icl-rocketry/Ricardo-CameraController/README.md

# Ricardo-CameraController
The CM5 (Compute Module 5) carrier board for cameras on rocket
