icl-rocketry/Ricardo-CameraController/Camera-controller/Camera-controller.kicad_pcb

## KiCad design Camera-controller/Camera-controller.kicad_pcb (2026-06-25)

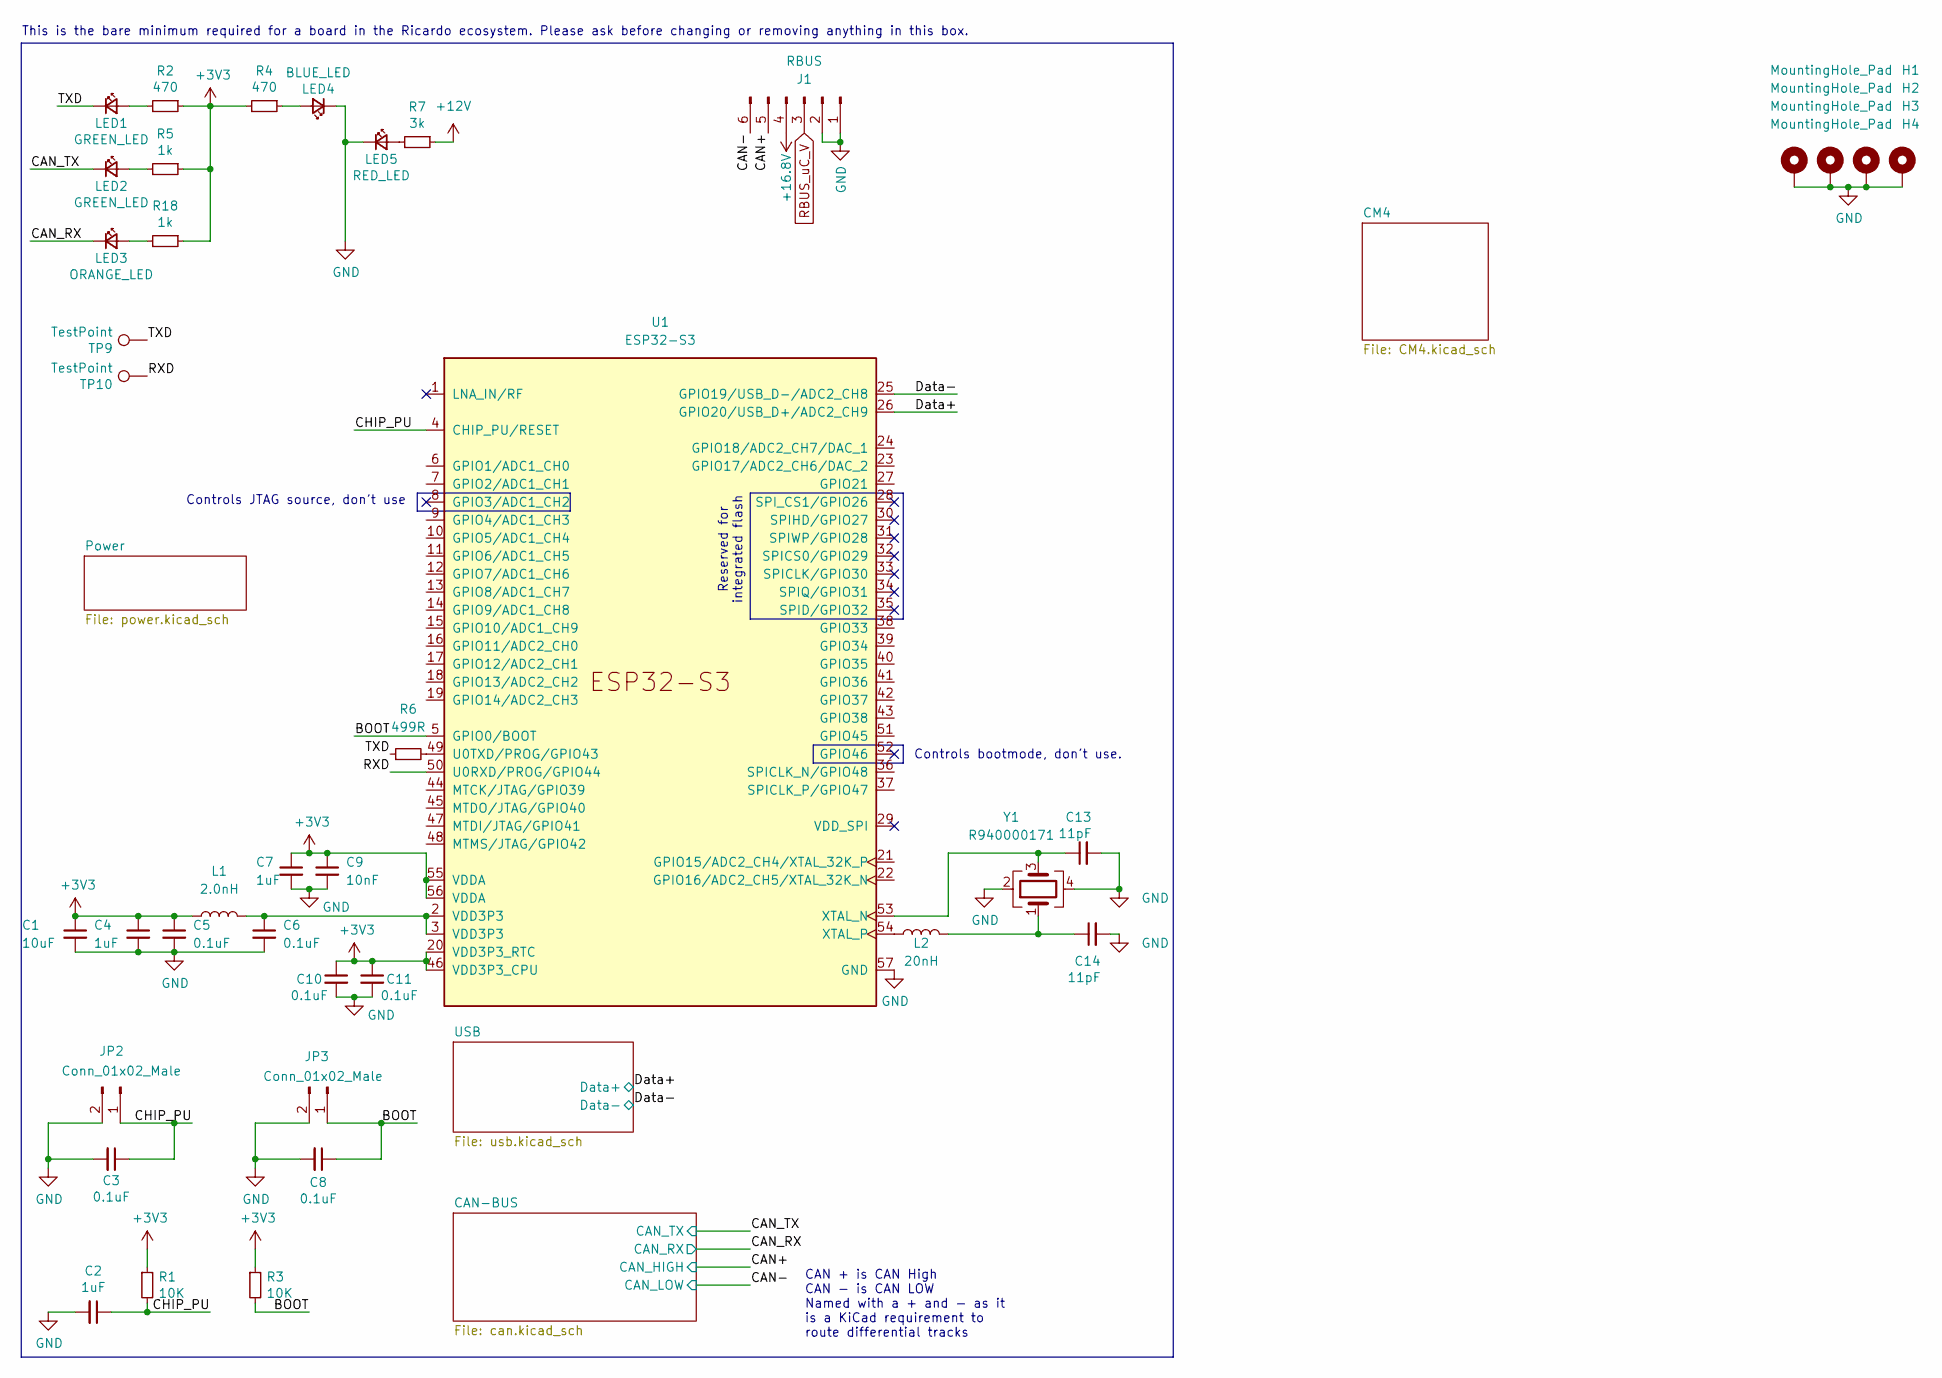
[picture p1: schematic Camera-controller.kicad_sch]

Parts:
C1: 10uF; C_0402_1005Metric
C2, C4, C7: 1uF; C_0402_1005Metric
C3, C5, C6, C8, C10, C11: 0.1uF; C_0402_1005Metric
C9: 10nF; C_0402_1005Metric
C13, C14: 11pF; C_0402_1005Metric
H1, H2, H3, H4: MountingHole_Pad; MountingHole_3.2mm_M3_DIN965_Pad
J1: RBUS; Molex_Mini-Fit_Jr_5569-06A2_2x03_P4.20mm_Horizontal
JP2, JP3: Conn_01x02_Male; PinHeader_1x02_P2.54mm_Vertical
L1: 2.0nH; L_0402_1005Metric
L2: 20nH; L_0402_1005Metric
LED1, LED2: GREEN_LED; LED_0402_1005Metric
LED3: ORANGE_LED; LED_0402_1005Metric
LED4: BLUE_LED; LED_0402_1005Metric
LED5: RED_LED; LED_0402_1005Metric
R1, R3: 10K; R_0402_1005Metric
R2, R4: 470; R_0402_1005Metric
R5, R18: 1k; R_0402_1005Metric
R6: 499R; R_0402_1005Metric
R7: 3k; R_0402_1005Metric
TP9, TP10: TestPoint; TestPoint_Pad_D1.0mm
U1: ESP32-S3; QFN40P700X700X90-57N
Y1: R940000171; Crystal_SMD_2016-4Pin_2.0x1.6mm

Connections:
+3V3: C1.1, C4.1, C5.1, C7.1, C9.1, C10.1, C11.1, L1.1, R1.1, R2.1, R3.1, R4.2, R5.1, R18.1, U1.20 (VDD3P3_RTC), U1.46 (VDD3P3_CPU), U1.55 (VDDA), U1.56 (VDDA); also elsewhere on the board
+12V: R7.1
+16.8V: J1.4; also elsewhere on the board
/BOOT: C8.1, JP3.1, R3.2, U1.5 (GPIO0/BOOT)
/CAN+: J1.5; also elsewhere on the board
/CAN-: J1.6; also elsewhere on the board
/CAN_RX: LED3.1 (K); also elsewhere on the board
/CAN_TX: LED2.1 (K); also elsewhere on the board
/CHIP_PU: C2.1, C3.1, JP2.1, R1.2, U1.4 (CHIP_PU/RESET)
/Data+: U1.26 (GPIO20/USB_D+/ADC2_CH9); also elsewhere on the board
/Data-: U1.25 (GPIO19/USB_D-/ADC2_CH8); also elsewhere on the board
/RXD: TP10.1, U1.50 (U0RXD/PROG/GPIO44)
/TXD: LED1.1 (K), R6.1, TP9.1
GND: C1.2, C2.2, C3.2, C4.2, C5.2, C6.2, C7.2, C8.2, C9.2, C10.2, C11.2, C13.2, C14.2, H1.1, H2.1, H3.1, H4.1, J1.1, J1.2, JP2.2, JP3.2, LED4.1 (K), LED5.1 (K), U1.57 (GND), Y1.2, Y1.4; also elsewhere on the board
unnamed: C6.1, L1.2, U1.2 (VDD3P3), U1.3 (VDD3P3)
unnamed: C14.1, L2.2, Y1.1
unnamed: LED1.2 (A), R2.2
unnamed: LED2.2 (A), R5.2
unnamed: LED3.2 (A), R18.2
unnamed: LED4.2 (A), R4.1
unnamed: LED5.2 (A), R7.2
unnamed: R6.2, U1.49 (U0TXD/PROG/GPIO43)
unnamed: C13.1, U1.53 (XTAL_N), Y1.3
unnamed: L2.1, U1.54 (XTAL_P)
RBUS_uC_V: J1.3; also elsewhere on the board

Notes on the sheet:
Controls bootmode, don't use.
This is the bare minimum required for a board in the Ricardo ecosystem. Please ask before changing or removing anything in this box.
CAN + is CAN High CAN - is CAN LOW Named with a + and - as it is a KiCad requirement to route differential tracks
Controls JTAG source, don't use
Reserved for integrated flash

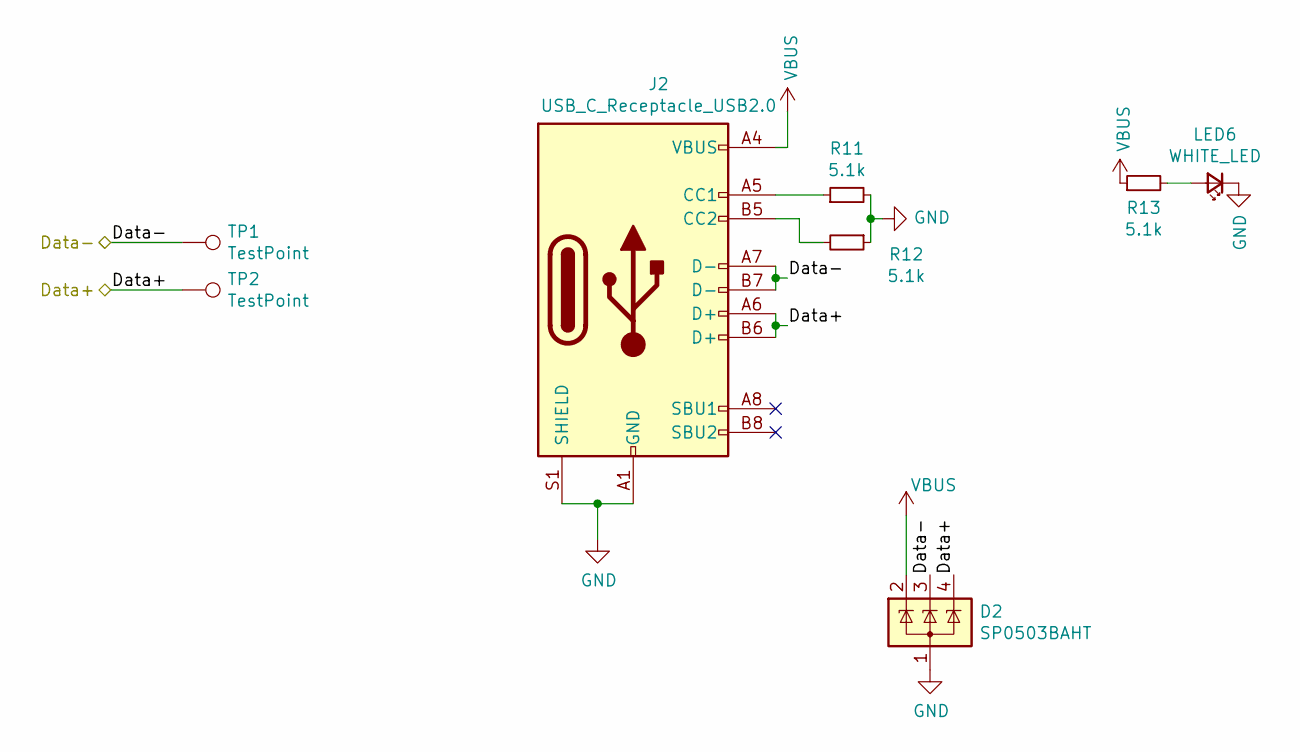
[picture p2: schematic usb.kicad_sch]

Parts:
D2: SP0503BAHT; SOT-143
J2: USB_C_Receptacle_USB2.0; USB_C_Receptacle_Palconn_UTC16-G
LED6: WHITE_LED; LED_0402_1005Metric
R11, R12, R13: 5.1k; R_0402_1005Metric
TP1, TP2: TestPoint; TestPoint_Pad_D1.0mm

Connections:
/Data+: D2.4 (K), J2.A6 (D+), J2.B6 (D+), TP2.1; also elsewhere on the board
/Data-: D2.3 (K), J2.A7 (D-), J2.B7 (D-), TP1.1; also elsewhere on the board
GND: D2.1 (A), J2.A1 (GND), J2.A12 (GND), J2.B1 (GND), J2.B12 (GND), J2.S1 (SHIELD), LED6.1 (K), R11.2, R12.1; also elsewhere on the board
unnamed: J2.A5 (CC1), R11.1
unnamed: J2.B5 (CC2), R12.2
unnamed: LED6.2 (A), R13.2
VBUS: D2.2 (K), J2.A4 (VBUS), J2.A9 (VBUS), J2.B4 (VBUS), J2.B9 (VBUS), R13.1; also elsewhere on the board

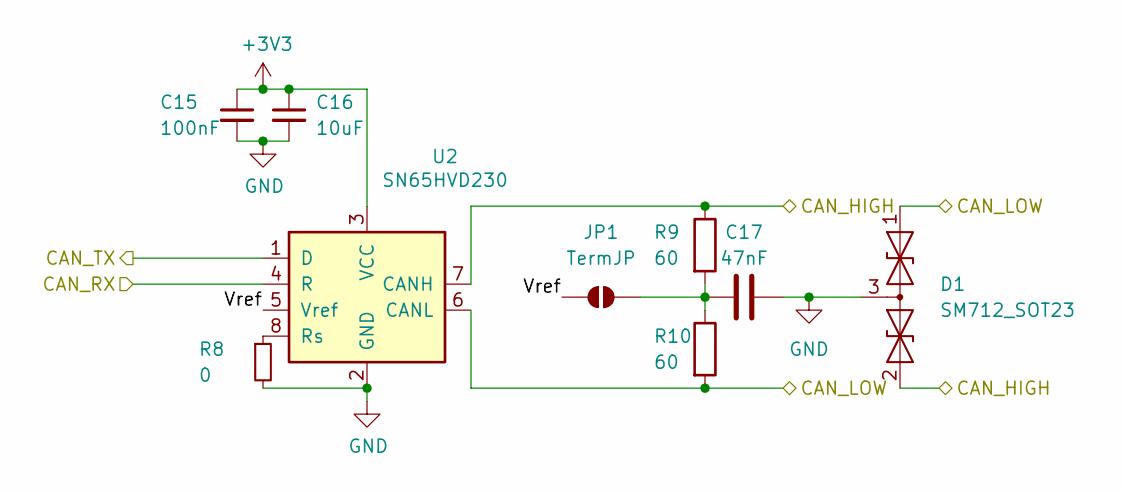
[picture p3: schematic can.kicad_sch]

Parts:
C15: 100nF; C_0402_1005Metric
C16: 10uF; C_0402_1005Metric
C17: 47nF; C_0402_1005Metric
D1: SM712_SOT23; SOT-23
JP1: TermJP; SmallerSolderJP
R8: 0; R_0603_1608Metric
R9, R10: 60; R_0603_1608Metric
U2: SN65HVD230; SOIC-8_3.9x4.9mm_P1.27mm

Connections:
+3V3: C15.1, C16.1, U2.3 (VCC); also elsewhere on the board
/CAN+: D1.2 (A2), R9.1, U2.7 (CANH); also elsewhere on the board
/CAN-: D1.1 (A1), R10.2, U2.6 (CANL); also elsewhere on the board
/CAN-BUS/Vref: JP1.1 (A), U2.5 (Vref)
/CAN_RX: U2.4 (R); also elsewhere on the board
/CAN_TX: U2.1 (D); also elsewhere on the board
GND: C15.2, C16.2, C17.2, D1.3 (common), R8.2, U2.2 (GND); also elsewhere on the board
unnamed: C17.1, JP1.2 (B), R9.2, R10.1
unnamed: R8.1, U2.8 (Rs)

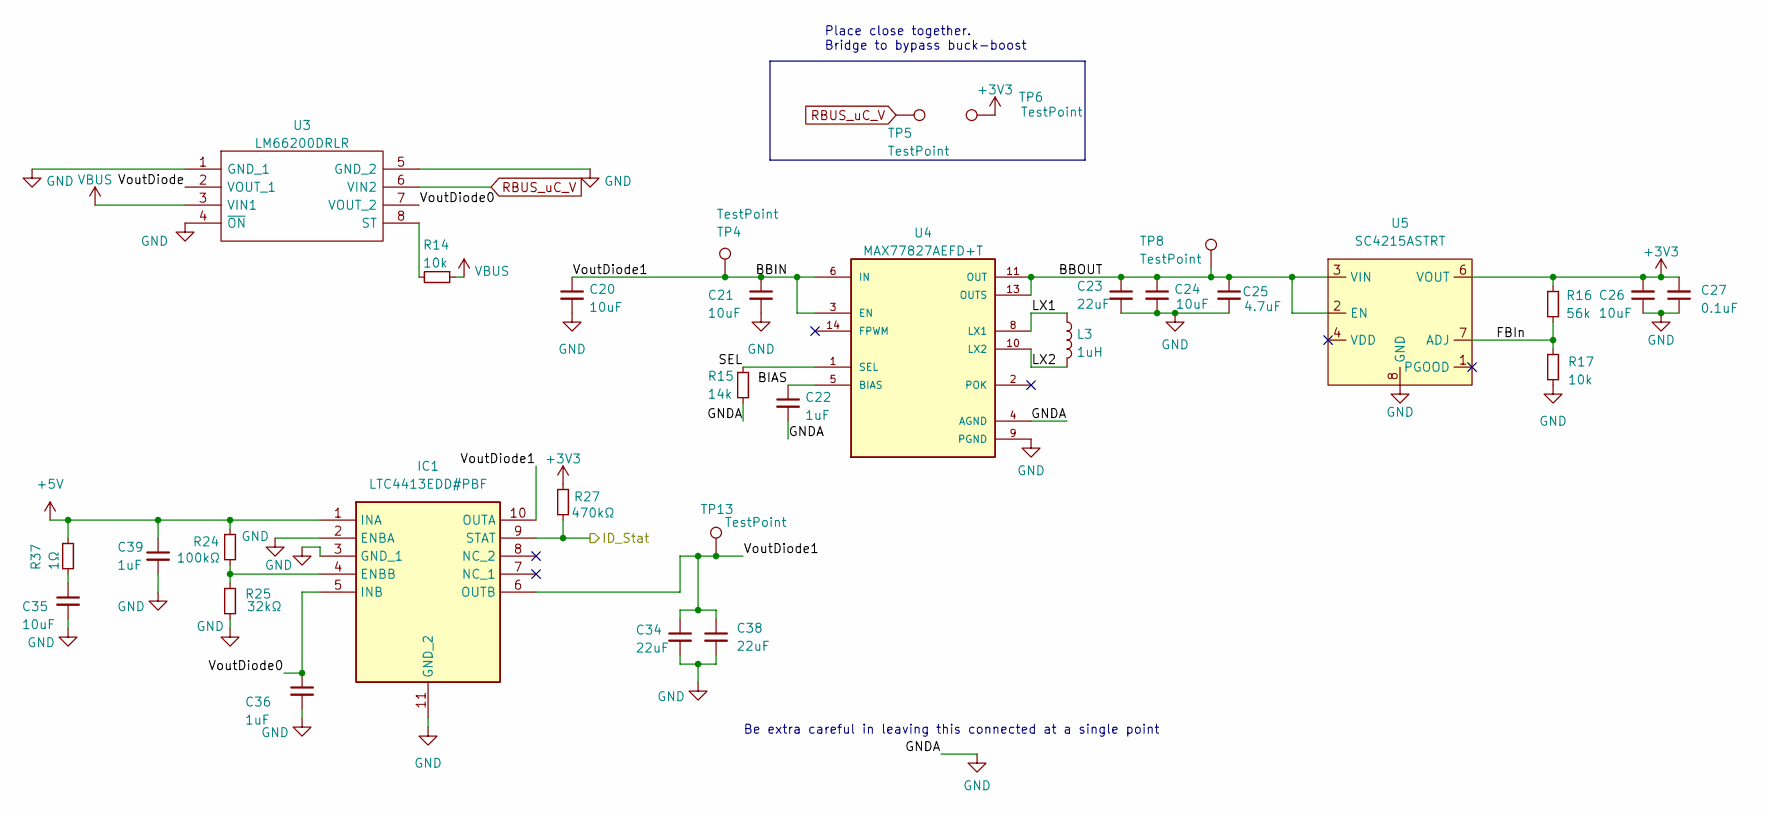
[picture p4: schematic power.kicad_sch]

Parts:
C20, C24, C26, C35: 10uF; C_0402_1005Metric
C21: 10uF; C_0603_1608Metric
C22, C36, C39: 1uF; C_0402_1005Metric
C23: 22uF; C_0603_1608Metric
C25: 4.7uF; C_0402_1005Metric
C27: 0.1uF; C_0402_1005Metric
C34, C38: 22uF; C_0402_1005Metric
IC1: LTC4413EDD#PBF; SON50P300X300X80-11N-D; Mouser Part Number 584-LTC4413EDD#PBF
L3: 1uH; L_0805_2012Metric
R14, R17: 10k; R_0402_1005Metric
R15: 14k; R_0402_1005Metric
R16: 56k; R_0402_1005Metric
R24: 100kΩ; R_0402_1005Metric
R25: 32kΩ; R_0402_1005Metric
R27: 470kΩ; R_0402_1005Metric
R37: 1Ω; R_0402_1005Metric
TP4, TP5, TP6, TP8: TestPoint; TestPoint_Pad_D1.5mm
TP13: TestPoint; TestPoint_Pad_D1.0mm
U3: LM66200DRLR; SOTFL50P160X60-8N; Manufacturer_Part_Number LM66200DRLR; Mouser Part Number 595-LM66200DRLR
U4: MAX77827AEFD+T; CONV_MAX77827AEFD+T; PARTREV B
U5: SC4215ASTRT; SOIC127P599X175-9N

Connections:
+3V3: C26.2, C27.2, R16.1, R27.1, TP6.1, U5.6 (VOUT); also elsewhere on the board
+5V: C39.1, IC1.1 (INA), R24.1, R37.1; also elsewhere on the board
/Power/BBIN: C20.1, C21.1, C34.1, C38.1, IC1.6 (OUTB), IC1.10 (OUTA), TP4.1, TP13.1, U4.3 (EN), U4.6 (IN)
/Power/BBOUT: C23.1, C24.1, C25.1, TP8.1, U4.11 (OUT), U4.13 (OUTS), U5.2 (EN), U5.3 (VIN)
/Power/BIAS: C22.1, U4.5 (BIAS)
/Power/FBIn: R16.2, R17.1, U5.7 (ADJ)
/Power/ID_Stat: IC1.9 (STAT), R27.2
/Power/LX1: L3.1, U4.8 (LX1)
/Power/LX2: L3.2, U4.10 (LX2)
/Power/SEL: R15.1, U4.1 (SEL)
/Power/VoutDiode: U3.2 (VOUT_1)
/Power/VoutDiode0: C36.1, IC1.5 (INB), U3.7 (VOUT_2)
GND: C20.2, C21.2, C22.2, C23.2, C24.2, C25.2, C26.1, C27.1, C34.2, C35.2, C36.2, C38.2, C39.2, IC1.2 (ENBA), IC1.3 (GND_1), IC1.11 (GND_2), R15.2, R17.2, R25.2, U3.1 (GND_1), U3.4 (~ON), U3.5 (GND_2), U4.4 (AGND), U4.9 (PGND), U5.8 (GND), U5.9 (GND); also elsewhere on the board
unnamed: C35.1, R37.2
unnamed: IC1.4 (ENBB), R24.2, R25.1
unnamed: R14.2, U3.8 (ST)
RBUS_uC_V: TP5.1, U3.6 (VIN2); also elsewhere on the board
VBUS: R14.1, U3.3 (VIN1); also elsewhere on the board

Notes on the sheet:
Place close together. Bridge to bypass buck-boost
Be extra careful in leaving this connected at a single point

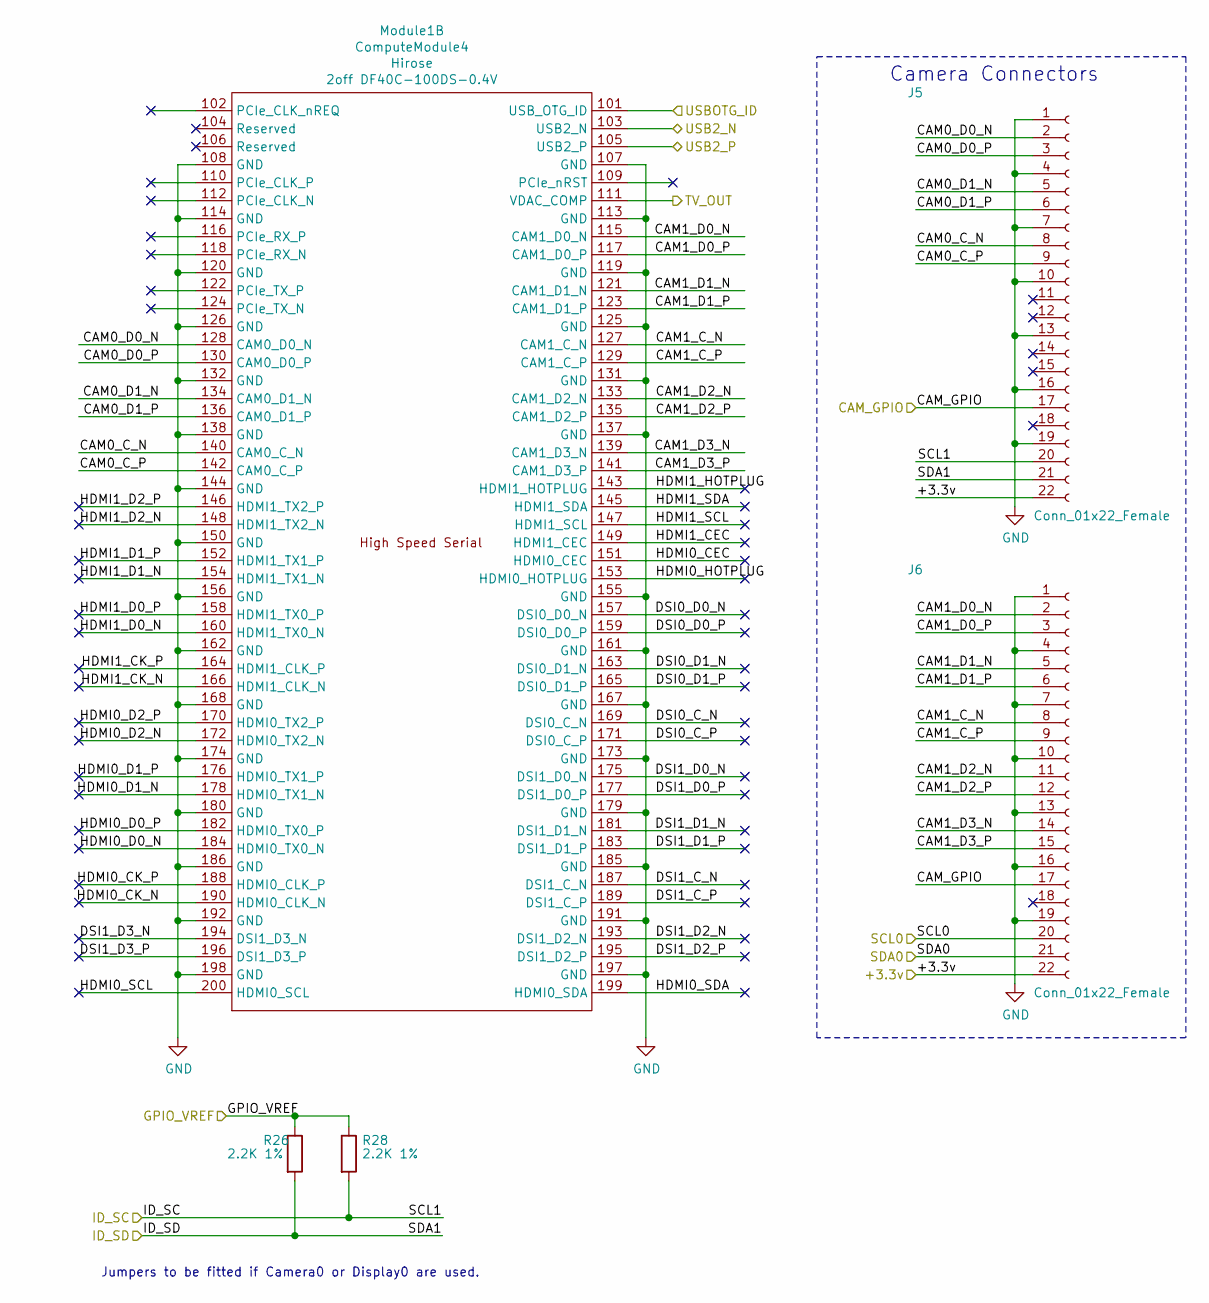
[picture p5: schematic CM4_HighSpeed.kicad_sch, Compute Module 4 IO Board - CM4 - Highspeed]

Parts:
J5, J6: Conn_01x22_Female; Hirose_FH12-22S-0.5SH_1x22-1MP_P0.50mm_Horizontal; Part Description 22 Position FFC, FPC Connector Contacts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
Module1: ComputeModule4; Raspberry-Pi-4-Compute-Module; Part Description 100 Position Connector Receptacle, Cent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
R26, R28: 2.2K 1%; R_0402_1005Metric; Part Description Resistor 2.2K M1005 1% 63mW

Connections:
/CM4/+3.3v: J5.22, J6.22; also elsewhere on the board
/CM4/CM4 _HighSpeed/CAM0_C_N: J5.8, Module1.140 (CAM0_C_N)
/CM4/CM4 _HighSpeed/CAM0_C_P: J5.9, Module1.142 (CAM0_C_P)
/CM4/CM4 _HighSpeed/CAM0_D0_N: J5.2, Module1.128 (CAM0_D0_N)
/CM4/CM4 _HighSpeed/CAM0_D0_P: J5.3, Module1.130 (CAM0_D0_P)
/CM4/CM4 _HighSpeed/CAM0_D1_N: J5.5, Module1.134 (CAM0_D1_N)
/CM4/CM4 _HighSpeed/CAM0_D1_P: J5.6, Module1.136 (CAM0_D1_P)
/CM4/CM4 _HighSpeed/CAM1_C_N: J6.8, Module1.127 (CAM1_C_N)
/CM4/CM4 _HighSpeed/CAM1_C_P: J6.9, Module1.129 (CAM1_C_P)
/CM4/CM4 _HighSpeed/CAM1_D0_N: J6.2, Module1.115 (CAM1_D0_N)
/CM4/CM4 _HighSpeed/CAM1_D0_P: J6.3, Module1.117 (CAM1_D0_P)
/CM4/CM4 _HighSpeed/CAM1_D1_N: J6.5, Module1.121 (CAM1_D1_N)
/CM4/CM4 _HighSpeed/CAM1_D1_P: J6.6, Module1.123 (CAM1_D1_P)
/CM4/CM4 _HighSpeed/CAM1_D2_N: J6.11, Module1.133 (CAM1_D2_N)
/CM4/CM4 _HighSpeed/CAM1_D2_P: J6.12, Module1.135 (CAM1_D2_P)
/CM4/CM4 _HighSpeed/CAM1_D3_N: J6.14, Module1.139 (CAM1_D3_N)
/CM4/CM4 _HighSpeed/CAM1_D3_P: J6.15, Module1.141 (CAM1_D3_P)
/CM4/CM4 _HighSpeed/CAM_GPIO: J5.17, J6.17; also elsewhere on the board
/CM4/CM4 _HighSpeed/DSI0_C_N: Module1.169 (DSI0_C_N)
/CM4/CM4 _HighSpeed/DSI0_C_P: Module1.171 (DSI0_C_P)
/CM4/CM4 _HighSpeed/DSI0_D0_N: Module1.157 (DSI0_D0_N)
/CM4/CM4 _HighSpeed/DSI0_D0_P: Module1.159 (DSI0_D0_P)
/CM4/CM4 _HighSpeed/DSI0_D1_N: Module1.163 (DSI0_D1_N)
/CM4/CM4 _HighSpeed/DSI0_D1_P: Module1.165 (DSI0_D1_P)
/CM4/CM4 _HighSpeed/DSI1_C_N: Module1.187 (DSI1_C_N)
/CM4/CM4 _HighSpeed/DSI1_C_P: Module1.189 (DSI1_C_P)
/CM4/CM4 _HighSpeed/DSI1_D0_N: Module1.175 (DSI1_D0_N)
/CM4/CM4 _HighSpeed/DSI1_D0_P: Module1.177 (DSI1_D0_P)
/CM4/CM4 _HighSpeed/DSI1_D1_N: Module1.181 (DSI1_D1_N)
/CM4/CM4 _HighSpeed/DSI1_D1_P: Module1.183 (DSI1_D1_P)
/CM4/CM4 _HighSpeed/DSI1_D2_N: Module1.193 (DSI1_D2_N)
/CM4/CM4 _HighSpeed/DSI1_D2_P: Module1.195 (DSI1_D2_P)
/CM4/CM4 _HighSpeed/DSI1_D3_N: Module1.194 (DSI1_D3_N)
/CM4/CM4 _HighSpeed/DSI1_D3_P: Module1.196 (DSI1_D3_P)
/CM4/CM4 _HighSpeed/GPIO_VREF: R26.1, R28.1; also elsewhere on the board
/CM4/CM4 _HighSpeed/HDMI0_CEC: Module1.151 (HDMI0_CEC)
/CM4/CM4 _HighSpeed/HDMI0_CK_N: Module1.190 (HDMI0_CLK_N)
/CM4/CM4 _HighSpeed/HDMI0_CK_P: Module1.188 (HDMI0_CLK_P)
/CM4/CM4 _HighSpeed/HDMI0_D0_N: Module1.184 (HDMI0_TX0_N)
/CM4/CM4 _HighSpeed/HDMI0_D0_P: Module1.182 (HDMI0_TX0_P)
/CM4/CM4 _HighSpeed/HDMI0_D1_N: Module1.178 (HDMI0_TX1_N)
/CM4/CM4 _HighSpeed/HDMI0_D1_P: Module1.176 (HDMI0_TX1_P)
/CM4/CM4 _HighSpeed/HDMI0_D2_N: Module1.172 (HDMI0_TX2_N)
/CM4/CM4 _HighSpeed/HDMI0_D2_P: Module1.170 (HDMI0_TX2_P)
/CM4/CM4 _HighSpeed/HDMI0_HOTPLUG: Module1.153 (HDMI0_HOTPLUG)
/CM4/CM4 _HighSpeed/HDMI0_SCL: Module1.200 (HDMI0_SCL)
/CM4/CM4 _HighSpeed/HDMI0_SDA: Module1.199 (HDMI0_SDA)
/CM4/CM4 _HighSpeed/HDMI1_CEC: Module1.149 (HDMI1_CEC)
/CM4/CM4 _HighSpeed/HDMI1_CK_N: Module1.166 (HDMI1_CLK_N)
/CM4/CM4 _HighSpeed/HDMI1_CK_P: Module1.164 (HDMI1_CLK_P)
/CM4/CM4 _HighSpeed/HDMI1_D0_N: Module1.160 (HDMI1_TX0_N)
/CM4/CM4 _HighSpeed/HDMI1_D0_P: Module1.158 (HDMI1_TX0_P)
/CM4/CM4 _HighSpeed/HDMI1_D1_N: Module1.154 (HDMI1_TX1_N)
/CM4/CM4 _HighSpeed/HDMI1_D1_P: Module1.152 (HDMI1_TX1_P)
/CM4/CM4 _HighSpeed/HDMI1_D2_N: Module1.148 (HDMI1_TX2_N)
/CM4/CM4 _HighSpeed/HDMI1_D2_P: Module1.146 (HDMI1_TX2_P)
/CM4/CM4 _HighSpeed/HDMI1_HOTPLUG: Module1.143 (HDMI1_HOTPLUG)
/CM4/CM4 _HighSpeed/HDMI1_SCL: Module1.147 (HDMI1_SCL)
/CM4/CM4 _HighSpeed/HDMI1_SDA: Module1.145 (HDMI1_SDA)
/CM4/CM4 _HighSpeed/ID_SC: J5.20, R28.2; also elsewhere on the board
/CM4/CM4 _HighSpeed/ID_SD: J5.21, R26.2; also elsewhere on the board
/CM4/CM4 _HighSpeed/SCL0: J6.20; also elsewhere on the board
/CM4/CM4 _HighSpeed/SDA0: J6.21; also elsewhere on the board
/CM4/CM4 _HighSpeed/USBOTG_ID: Module1.101 (USB_OTG_ID); also elsewhere on the board
/CM4/CM4_GPIO/TV_OUT: Module1.111 (VDAC_COMP); also elsewhere on the board
/CM4/CM4_USB/USB2_N: Module1.103 (USB2_N); also elsewhere on the board
/CM4/CM4_USB/USB2_P: Module1.105 (USB2_P); also elsewhere on the board
GND: J5.1, J5.4, J5.7, J5.10, J5.13, J5.16, J5.19, J6.1, J6.4, J6.7, J6.10, J6.13, J6.16, J6.19, Module1.107 (GND), Module1.108 (GND), Module1.113 (GND), Module1.114 (GND), Module1.119 (GND), Module1.120 (GND), Module1.125 (GND), Module1.126 (GND), Module1.131 (GND), Module1.132 (GND), Module1.137 (GND), Module1.138 (GND), Module1.144 (GND), Module1.150 (GND), Module1.155 (GND), Module1.156 (GND), Module1.161 (GND), Module1.162 (GND), Module1.167 (GND), Module1.168 (GND), Module1.173 (GND), Module1.174 (GND), Module1.179 (GND), Module1.180 (GND), Module1.185 (GND), Module1.186 (GND), Module1.191 (GND), Module1.192 (GND), Module1.197 (GND), Module1.198 (GND); also elsewhere on the board

Notes on the sheet:
Jumpers to be fitted if Camera0 or Display0 are used.
Camera Connectors

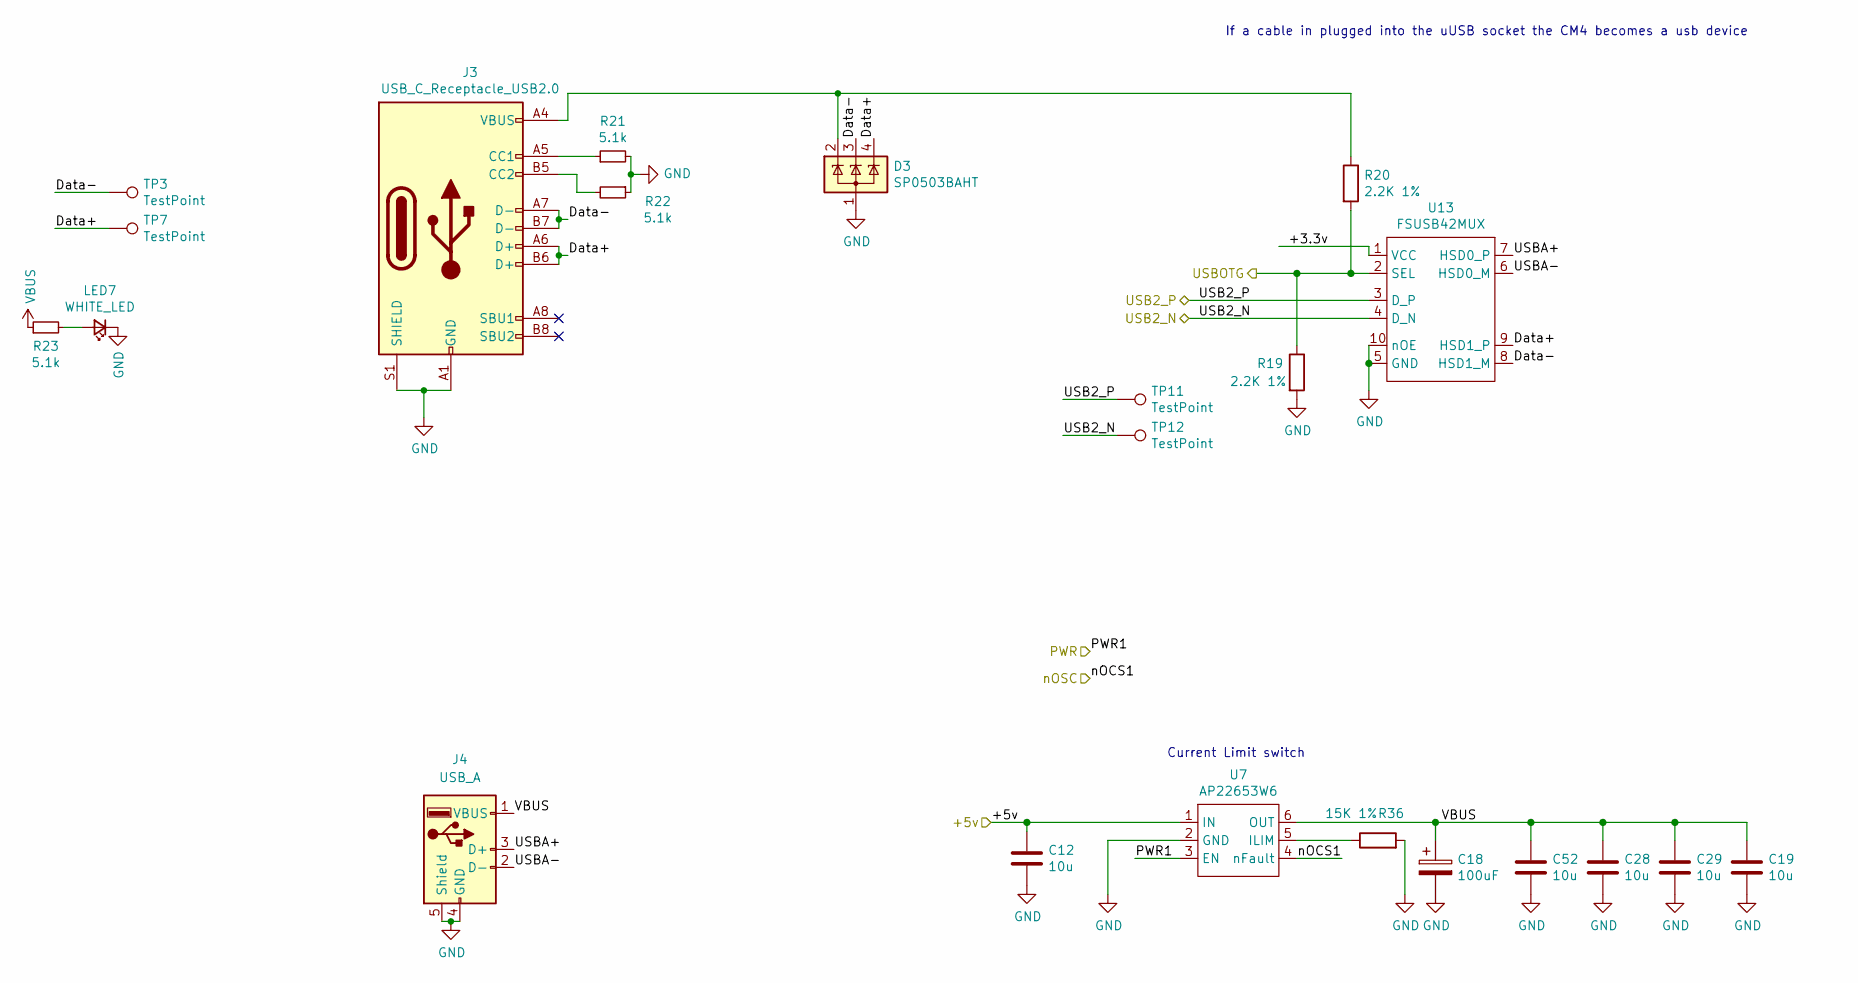
[picture p6: schematic CM4_USB.kicad_sch]

Parts:
C12, C19, C28, C29, C52: 10u; C_0805_2012Metric; Part Description 10uF 10% 10V Ceramic Capacitor X7R 0805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
C18: 100uF; CP_EIA-7343-31_Kemet-D; Part Description Capacitor, SP-Cap, 100u, 6.3V, 15mR ESR
D3: SP0503BAHT; SOT-143
J3: USB_C_Receptacle_USB2.0; USB_C_Receptacle_Palconn_UTC16-G
J4: USB_A; USB_A_Wuerth_614004134726_Horizontal
LED7: WHITE_LED; LED_0402_1005Metric
R19, R20: 2.2K 1%; R_0402_1005Metric; Part Description Resistor 2.2K M1005 1% 63mW
R21, R22, R23: 5.1k; R_0402_1005Metric
R36: 15K 1%; R_0402_1005Metric; Part Description Resistor 15K M1005 1% 63mW
TP3, TP7, TP11, TP12: TestPoint; TestPoint_Pad_D1.0mm
U7: AP22653W6; SOT-23-6; Part Description Power Switch/Driver 1:1 P-Channel 2.1A 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
U13: FSUSB42MUX; MSOP-10_3x3mm_P0.5mm; Part Description USB Switch IC 1 Channel 10-MSOP

Connections:
+5V: C12.1, U7.1 (IN); also elsewhere on the board
/CM4/CM4 _HighSpeed/USBOTG_ID: R19.1, R20.2, U13.2 (SEL); also elsewhere on the board
/CM4/CM4_USB/+3.3v: U13.1 (VCC)
/CM4/CM4_USB/Data+: D3.4 (K), J3.A6 (D+), J3.B6 (D+), TP7.1, U13.9 (HSD1_P)
/CM4/CM4_USB/Data-: D3.3 (K), J3.A7 (D-), J3.B7 (D-), TP3.1, U13.8 (HSD1_M)
/CM4/CM4_USB/PWR1: U7.3 (EN)
/CM4/CM4_USB/USB2_N: TP12.1, U13.4 (D_N); also elsewhere on the board
/CM4/CM4_USB/USB2_P: TP11.1, U13.3 (D_P); also elsewhere on the board
/CM4/CM4_USB/USBA+: J4.3 (D+), U13.7 (HSD0_P)
/CM4/CM4_USB/USBA-: J4.2 (D-), U13.6 (HSD0_M)
/CM4/CM4_USB/nOCS1: U7.4 (nFault)
GND: C12.2, C18.2, C19.2, C28.2, C29.2, C52.2, D3.1 (A), J3.A1 (GND), J3.A12 (GND), J3.B1 (GND), J3.B12 (GND), J3.S1 (SHIELD), J4.4 (GND), J4.5 (Shield), LED7.1 (K), R19.2, R21.2, R22.1, R36.2, U7.2 (GND), U13.5 (GND), U13.10 (nOE); also elsewhere on the board
unnamed: D3.2 (K), J3.A4 (VBUS), J3.A9 (VBUS), J3.B4 (VBUS), J3.B9 (VBUS), R20.1
unnamed: J3.A5 (CC1), R21.1
unnamed: J3.B5 (CC2), R22.2
unnamed: LED7.2 (A), R23.2
unnamed: R36.1, U7.5 (ILIM)
VBUS: C18.1, C19.1, C28.1, C29.1, C52.1, J4.1 (VBUS), R23.1, U7.6 (OUT); also elsewhere on the board

Notes on the sheet:
If a cable in plugged into the uUSB socket the CM4 becomes a usb device
Current Limit switch
