icl-rocketry/Ricardo-CameraController/Camera-controller/Camera-controller.kicad_pcb

## KiCad design Camera-controller/Camera-controller.kicad_pcb (continued)

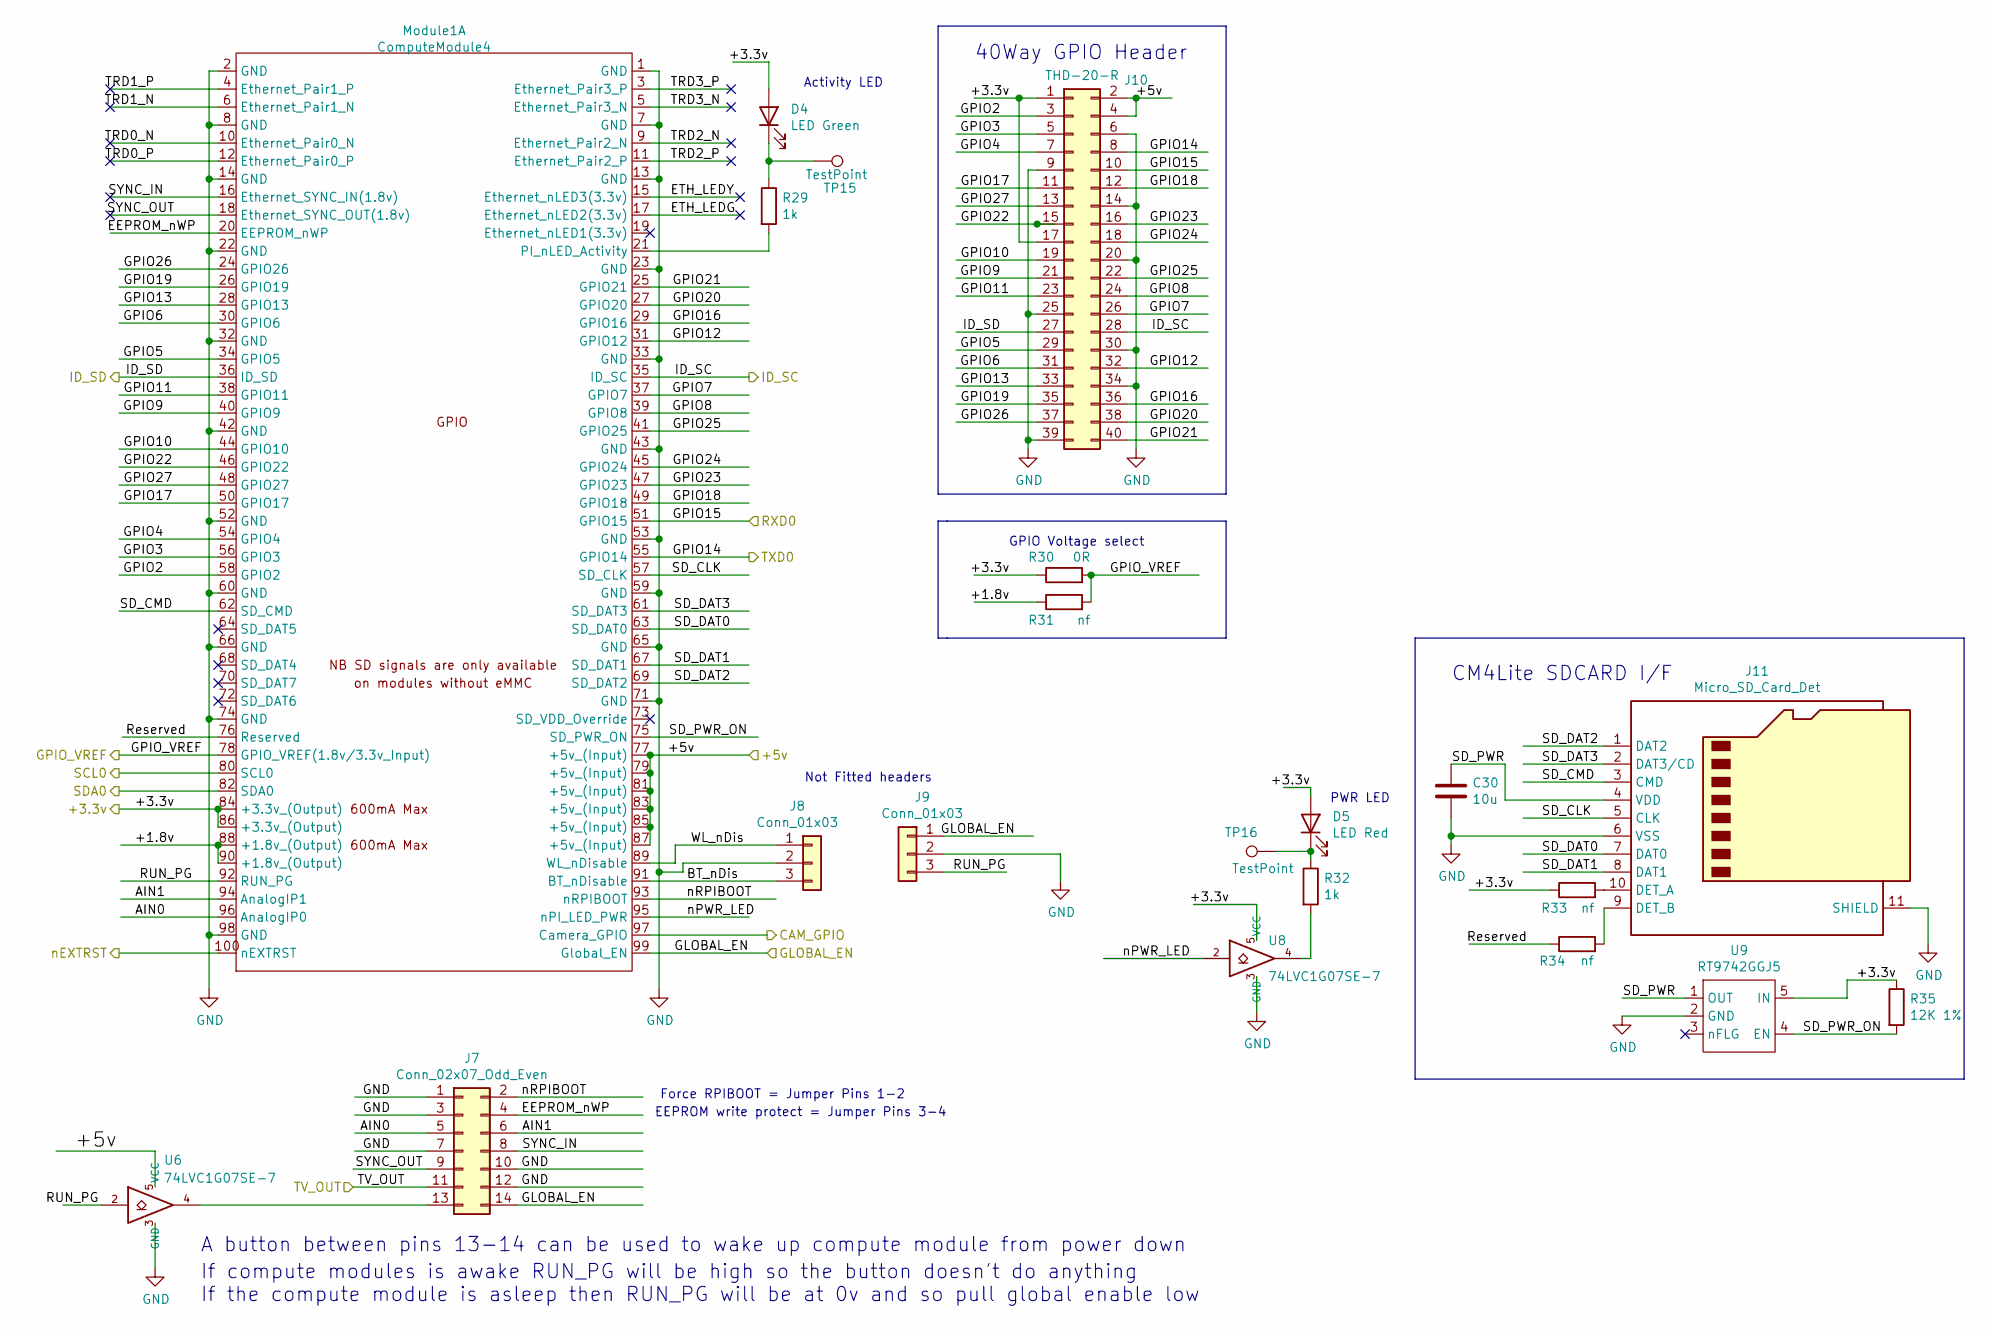
[picture p7: schematic CM4_GPIO.kicad_sch, Compute Module 4 IO Board - GPIO - Ethernet]

Parts:
C30: 10u; C_0805_2012Metric; Part Description 10uF 10% 10V Ceramic Capacitor X7R 0805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
D4: LED Green; LED_0603_1608Metric; Part Description Green 572nm LED Indication - Discrete 2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
D5: LED Red; LED_0603_1608Metric; Part Description Red 620nm LED Indication - Discrete 2.2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
J7: Conn_02x07_Odd_Even; PinHeader_2x07_P2.54mm_Vertical; Part Description PinHeader_2x07_P2.54mm_Vertical
J8, J9: Conn_01x03; PinHeader_1x03_P2.54mm_Vertical; Part Description 3pin 0.1" connector
J10: THD-20-R; PinHeader_2x20_P2.54mm_Vertical; Part Description PinHeader_2x20_P2.54mm_Vertical
J11: Micro_SD_Card_Det; SDCARD_MOLEX_503398-1892; Part Description 9 (8 + 1) Position Card Connector micro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
Module1: ComputeModule4; Raspberry-Pi-4-Compute-Module; Part Description 100 Position Connector Receptacle, Cent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
R29, R32: 1k; R_0402_1005Metric; Part Description Resistor 1K M1005 1% 63mW
R30: 0R; R_0402_1005Metric; Part Description Resistor 0R M2012 5%
R31: nf; R_0402_1005Metric
R33, R34: nf; R_0402_1005Metric; Part Description Resistor 1K M1005 1% 63mW
R35: 12K 1%; R_0402_1005Metric; Part Description Resistor 12K M1005 1% 63mW
TP15, TP16: TestPoint; TestPoint_Pad_2.0x2.0mm
U6, U8: 74LVC1G07SE-7; SOT-353_SC-70-5; Part Description Buffer, Non-Inverting 1 Element 1 Bit p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
U9: RT9742GGJ5; SOT-23-5; Part Description Power Switch/Driver 1:1 N-Channel 1A TS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

Connections:
+5V: J10.2, J10.4, Module1.77 (+5v_(Input)), Module1.79 (+5v_(Input)), Module1.81 (+5v_(Input)), Module1.83 (+5v_(Input)), Module1.85 (+5v_(Input)), Module1.87 (+5v_(Input)), U6.5 (VCC); also elsewhere on the board
/CM4/+3.3v: D4.2 (A), D5.2 (A), J10.1, J10.17, Module1.84 (+3.3v_(Output)), Module1.86 (+3.3v_(Output)), R30.1, R33.1, R35.1, U8.5 (VCC), U9.5 (IN); also elsewhere on the board
/CM4/CM4 _HighSpeed/CAM_GPIO: Module1.97 (Camera_GPIO); also elsewhere on the board
/CM4/CM4 _HighSpeed/GPIO_VREF: Module1.78 (GPIO_VREF(1.8v/3.3v_Input)), R30.2, R31.2; also elsewhere on the board
/CM4/CM4 _HighSpeed/ID_SC: J10.28, Module1.35 (ID_SC); also elsewhere on the board
/CM4/CM4 _HighSpeed/ID_SD: J10.27, Module1.36 (ID_SD); also elsewhere on the board
/CM4/CM4 _HighSpeed/SCL0: Module1.80 (SCL0); also elsewhere on the board
/CM4/CM4 _HighSpeed/SDA0: Module1.82 (SDA0); also elsewhere on the board
/CM4/CM4_GPIO/+1.8v: Module1.88 (+1.8v_(Output)), Module1.90 (+1.8v_(Output)), R31.1
/CM4/CM4_GPIO/AIN0: J7.5, Module1.96 (AnalogIP0)
/CM4/CM4_GPIO/AIN1: J7.6, Module1.94 (AnalogIP1)
/CM4/CM4_GPIO/BT_nDis: J8.3, Module1.91 (BT_nDisable)
/CM4/CM4_GPIO/EEPROM_nWP: J7.4, Module1.20 (EEPROM_nWP)
/CM4/CM4_GPIO/ETH_LEDG: Module1.17 (Ethernet_nLED2(3.3v))
/CM4/CM4_GPIO/ETH_LEDY: Module1.15 (Ethernet_nLED3(3.3v))
/CM4/CM4_GPIO/GLOBAL_EN: J7.14, J9.1, Module1.99 (Global_EN)
/CM4/CM4_GPIO/GPIO2: J10.3, Module1.58 (GPIO2)
/CM4/CM4_GPIO/GPIO3: J10.5, Module1.56 (GPIO3)
/CM4/CM4_GPIO/GPIO4: J10.7, Module1.54 (GPIO4)
/CM4/CM4_GPIO/GPIO5: J10.29, Module1.34 (GPIO5)
/CM4/CM4_GPIO/GPIO6: J10.31, Module1.30 (GPIO6)
/CM4/CM4_GPIO/GPIO7: J10.26, Module1.37 (GPIO7)
/CM4/CM4_GPIO/GPIO8: J10.24, Module1.39 (GPIO8)
/CM4/CM4_GPIO/GPIO9: J10.21, Module1.40 (GPIO9)
/CM4/CM4_GPIO/GPIO10: J10.19, Module1.44 (GPIO10)
/CM4/CM4_GPIO/GPIO11: J10.23, Module1.38 (GPIO11)
/CM4/CM4_GPIO/GPIO12: J10.32, Module1.31 (GPIO12)
/CM4/CM4_GPIO/GPIO13: J10.33, Module1.28 (GPIO13)
/CM4/CM4_GPIO/GPIO14: J10.8, Module1.55 (GPIO14)
/CM4/CM4_GPIO/GPIO15: J10.10, Module1.51 (GPIO15)
/CM4/CM4_GPIO/GPIO16: J10.36, Module1.29 (GPIO16)
/CM4/CM4_GPIO/GPIO17: J10.11, Module1.50 (GPIO17)
/CM4/CM4_GPIO/GPIO18: J10.12, Module1.49 (GPIO18)
/CM4/CM4_GPIO/GPIO19: J10.35, Module1.26 (GPIO19)
/CM4/CM4_GPIO/GPIO20: J10.38, Module1.27 (GPIO20)
/CM4/CM4_GPIO/GPIO21: J10.40, Module1.25 (GPIO21)
/CM4/CM4_GPIO/GPIO22: J10.15, Module1.46 (GPIO22)
/CM4/CM4_GPIO/GPIO23: J10.16, Module1.47 (GPIO23)
/CM4/CM4_GPIO/GPIO24: J10.18, Module1.45 (GPIO24)
/CM4/CM4_GPIO/GPIO25: J10.22, Module1.41 (GPIO25)
/CM4/CM4_GPIO/GPIO26: J10.37, Module1.24 (GPIO26)
/CM4/CM4_GPIO/GPIO27: J10.13, Module1.48 (GPIO27)
/CM4/CM4_GPIO/RUN_PG: J9.3, Module1.92 (RUN_PG), U6.2
/CM4/CM4_GPIO/Reserved: Module1.76 (Reserved), R34.1
/CM4/CM4_GPIO/SD_CLK: J11.5 (CLK), Module1.57 (SD_CLK)
/CM4/CM4_GPIO/SD_CMD: J11.3 (CMD), Module1.62 (SD_CMD)
/CM4/CM4_GPIO/SD_DAT0: J11.7 (DAT0), Module1.63 (SD_DAT0)
/CM4/CM4_GPIO/SD_DAT1: J11.8 (DAT1), Module1.67 (SD_DAT1)
/CM4/CM4_GPIO/SD_DAT2: J11.1 (DAT2), Module1.69 (SD_DAT2)
/CM4/CM4_GPIO/SD_DAT3: J11.2 (DAT3/CD), Module1.61 (SD_DAT3)
/CM4/CM4_GPIO/SD_PWR: C30.1, J11.4 (VDD), U9.1 (OUT)
/CM4/CM4_GPIO/SD_PWR_ON: Module1.75 (SD_PWR_ON), R35.2, U9.4 (EN)
/CM4/CM4_GPIO/SYNC_IN: J7.8, Module1.16 (Ethernet_SYNC_IN(1.8v))
/CM4/CM4_GPIO/SYNC_OUT: J7.9, Module1.18 (Ethernet_SYNC_OUT(1.8v))
/CM4/CM4_GPIO/TRD0_N: Module1.10 (Ethernet_Pair0_N)
/CM4/CM4_GPIO/TRD0_P: Module1.12 (Ethernet_Pair0_P)
/CM4/CM4_GPIO/TRD1_N: Module1.6 (Ethernet_Pair1_N)
/CM4/CM4_GPIO/TRD1_P: Module1.4 (Ethernet_Pair1_P)
/CM4/CM4_GPIO/TRD2_N: Module1.9 (Ethernet_Pair2_N)
/CM4/CM4_GPIO/TRD2_P: Module1.11 (Ethernet_Pair2_P)
/CM4/CM4_GPIO/TRD3_N: Module1.5 (Ethernet_Pair3_N)
/CM4/CM4_GPIO/TRD3_P: Module1.3 (Ethernet_Pair3_P)
/CM4/CM4_GPIO/TV_OUT: J7.11; also elsewhere on the board
/CM4/CM4_GPIO/WL_nDis: J8.1, Module1.89 (WL_nDisable)
/CM4/CM4_GPIO/nEXTRST: Module1.100 (nEXTRST)
/CM4/CM4_GPIO/nPWR_LED: Module1.95 (nPI_LED_PWR), U8.2
/CM4/CM4_GPIO/nRPIBOOT: J7.2, Module1.93 (nRPIBOOT)
GND: C30.2, J7.1, J7.3, J7.7, J7.10, J7.12, J8.2, J9.2, J10.6, J10.9, J10.14, J10.20, J10.25, J10.30, J10.34, J10.39, J11.6 (VSS), J11.11 (SHIELD), Module1.1 (GND), Module1.2 (GND), Module1.7 (GND), Module1.8 (GND), Module1.13 (GND), Module1.14 (GND), Module1.22 (GND), Module1.23 (GND), Module1.32 (GND), Module1.33 (GND), Module1.42 (GND), Module1.43 (GND), Module1.52 (GND), Module1.53 (GND), Module1.59 (GND), Module1.60 (GND), Module1.65 (GND), Module1.66 (GND), Module1.71 (GND), Module1.74 (GND), Module1.98 (GND), U6.3 (GND), U8.3 (GND), U9.2 (GND); also elsewhere on the board
unnamed: D4.1 (K), R29.1, TP15.1
unnamed: D5.1 (K), R32.1, TP16.1
unnamed: J7.13, U6.4
unnamed: J11.10 (DET_A), R33.2
unnamed: J11.9 (DET_B), R34.2
unnamed: Module1.21 (PI_nLED_Activity), R29.2
unnamed: R32.2, U8.4

Notes on the sheet:
PWR LED
40Way GPIO Header
CM4Lite SDCARD I/F
GPIO Voltage select
Activity LED
EEPROM write protect = Jumper Pins 3-4
Not Fitted headers
A button between pins 13-14 can be used to wake up compute module from power down
If compute modules is awake RUN_PG will be high so the button doesn't do anything If the compute module is asleep then RUN_PG will be at 0v and so pull global enable low
Force RPIBOOT = Jumper Pins 1-2

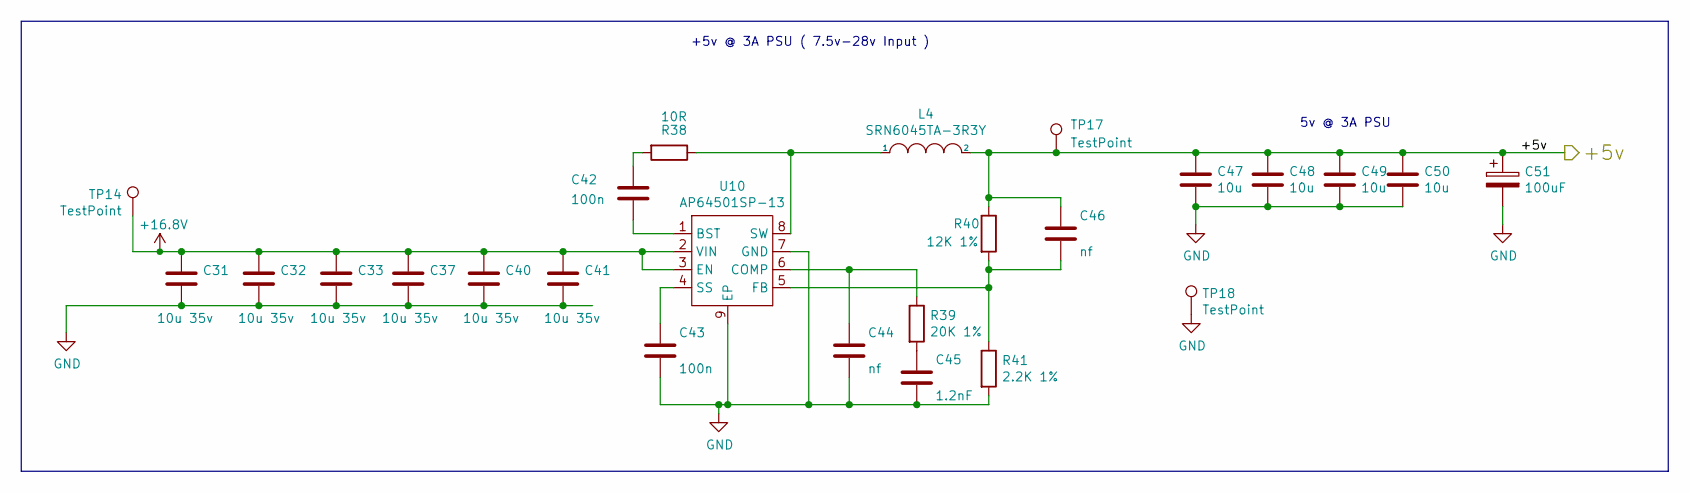
[picture p8: schematic PSUs.kicad_sch, Compute Module 4 IO Board - PSUs]

Parts:
C31, C32, C33, C37, C40, C41: 10u 35v; C_0805_2012Metric; Part Description 10uF 10% or 20% 35V Ceramic Capacitor X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
C42, C43: 100n; C_0402_1005Metric; Part Description 0.1uF 10% 16V Ceramic Capacitor X7R 040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
C44: nf; C_0402_1005Metric
C45: 1.2nF; C_0402_1005Metric; Part Description 1200pF 10% 10V Ceramic Capacitor X5R 04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
C46: nf; C_0402_1005Metric; Part Description 220 pF, 50 V, 0402 [1005 Metric], ± 5%,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
C47, C48, C49, C50: 10u; C_0805_2012Metric; Part Description 10uF 10% 10V Ceramic Capacitor X7R 0805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
C51: 100uF; CP_EIA-7343-31_Kemet-D; Part Description Capacitor, SP-Cap, 100u, 6.3V, 15mR ESR
L4: SRN6045TA-3R3Y; L_Bourns_SRN6045TA; Part Description 3.3µH Semi-Shielded Wirewound Inductor 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
R38: 10R; R_0402_1005Metric; Part Description Resistor 10R M1005 1% 63mW
R39: 20K 1%; R_0402_1005Metric; Part Description Resistor 20K M1005 1% 63mW
R40: 12K 1%; R_0402_1005Metric; Part Description Resistor 12K M1005 1% 63mW
R41: 2.2K 1%; R_0402_1005Metric; Part Description Resistor 2.2K M1005 1% 63mW
TP14, TP17, TP18: TestPoint; TestPoint_Pad_2.0x2.0mm
U10: AP64501SP-13; SOIC-8-1EP_3.9x4.9mm_P1.27mm_EP2.95x4.9mm_Mask2.71x3.4mm_Th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; Part Description Buck Switching Regulator IC Positive Ad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

Connections:
+5V: C46.1, C47.1, C48.1, C49.1, C50.1, C51.1, L4.2, R40.1, TP17.1; also elsewhere on the board
+16.8V: C31.1, C32.1, C33.1, C37.1, C40.1, C41.1, TP14.1, U10.2 (VIN), U10.3 (EN); also elsewhere on the board
GND: C31.2, C32.2, C33.2, C37.2, C40.2, C41.2, C43.2, C44.2, C45.2, C47.2, C48.2, C49.2, C50.2, C51.2, R41.2, TP18.1, U10.7 (GND), U10.9 (EP); also elsewhere on the board
unnamed: C42.1, R38.2
unnamed: C45.1, R39.2
unnamed: C42.2, U10.1 (BST)
unnamed: C44.1, R39.1, U10.6 (COMP)
unnamed: C46.2, R40.2, R41.1, U10.5 (FB)
unnamed: C43.1, U10.4 (SS)
unnamed: L4.1, R38.1, U10.8 (SW)

Notes on the sheet:
5v @ 3A PSU
+5v @ 3A PSU ( 7.5v-28v Input )

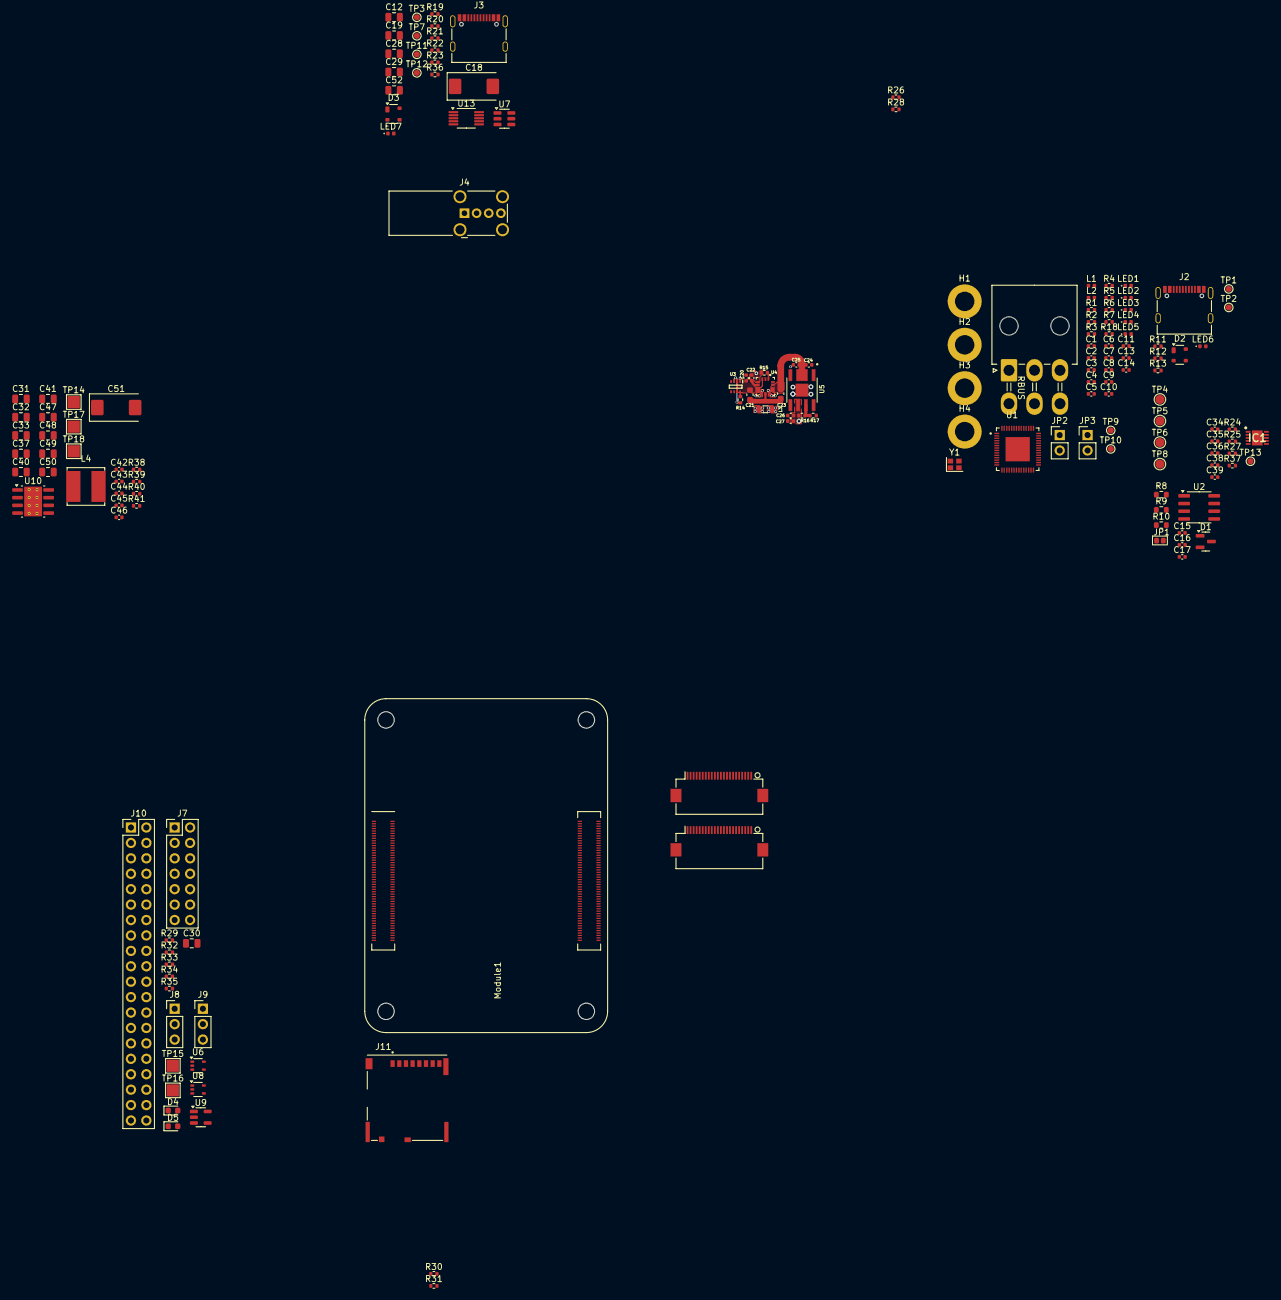
[picture p9: board Camera-controller.kicad_pcb from above]

Board: 4 copper layers, 159 parts (0 on the bottom side), 141 nets.
