icl-rocketry/Ricardo-CameraController/(commit log)

2026-02-03 KiCad project made
    [Camera-Controller.kicad_pcb, Camera-Controller.kicad_sch]
2026-02-03 Template cloned
    [Camera-Controller.kicad_pcb, Camera-Controller.kicad_sch, can.kicad_sch, power.kicad_sch, usb.kicad_sch]
2026-02-03 CM5 schematic drawn [KiCad]
    [CM5.kicad_sch, Camera-Controller.kicad_sch]
2026-02-17 Added CM5 reference board file
2026-02-24 Moved Camera-Controller-CM5IO to main folder
    [CM5IO.kicad_pcb, CM5IO.kicad_sch, CM5_GPIO.kicad_sch, CM5_HighSpeed.kicad_sch, PCIe-M2.kicad_sch]
2026-02-24 Attempted to delete HDMI from sch. #1
    [CM5IO.kicad_sch, CM5_GPIO.kicad_sch, CM5_HighSpeed.kicad_sch, PCIe-M2.kicad_sch]
2026-02-24 Moved CM5IO folder; Removed Ethernet, Battery (successfully?)
    [CM5IO.kicad_pcb, CM5IO.kicad_sch, CM5_GPIO.kicad_sch, CM5_HighSpeed.kicad_sch, PCIe-M2.kicad_sch]
2026-02-24 Copied Ricardo template on CM5IO board
    There's not enough space!!
    [CM5IO.kicad_pcb, CM5IO.kicad_sch, can.kicad_sch, power.kicad_sch, usb.kicad_sch]
2026-02-24 Duplicated additional USB-C in sch.
    How to change pin label on CM5?
    [CM5IO.kicad_sch, CM5_HighSpeed.kicad_sch, can.kicad_sch, power.kicad_sch, usb.kicad_sch]
2026-03-03 Moved Ricardo to hierarchical sheet in main sch.
    [CM5IO.kicad_sch, Ricardo.kicad_sch, can.kicad_sch, power.kicad_sch, usb.kicad_sch]
2026-03-03 Added "Buck Boost" hierarchical sheet; Deleted two USB-C ports
    [CM5IO.kicad_sch, CM5_HighSpeed.kicad_sch, buckboost.kicad_sch]
2026-03-10 Blocked off vbat
    still need to block off ethernet
    [CM5IO.kicad_pcb, CM5_GPIO.kicad_sch]
2026-03-14 Began design of RBUS(4-5V)-to-CM5(5V) boost
    R1, R2, R3 selected; Explained difference between GNDA and GND.
2026-03-17 Continued boost design
    R4, C1, C2, C3 selected
    R4, L1 unsure
    COMP, EN yet to be finished.
    [CM5IO.kicad_sch, buckboost.kicad_sch]
2026-03-17 C3 GND -> GNDA
    small mistake
    [buckboost.kicad_sch]
2026-06-11 EN L1 completed
    R_EN set to 800k (typ) (could be 10k) | L1 set to 2.2uH (744311220 Wurth); imported to iclr-hw
    [buckboost.kicad_sch]
2026-06-16 Edited I/O port names for consistency
    e.g. FSW_IN & FSW_OUT -> FSW_IO
    [buckboost.kicad_sch]
2026-06-16 EN changed & finalised
    Added MOSFET; using potential divider (i.e. R7//R8) EN switch is at 1.65V which is >1.2V from the data sheet. Added C7 to avoid voltage spikes.
    [buckboost.kicad_sch]
2026-06-16 COMP completed
    η ≈ 85% | D = 0.45 | R_O = 1.67Ω | f_RHPZ = 36546 Hz | f_C ≈ 7 kHz | R5 = 6.2kΩ | C5 = 6 nF | R_ESR ≈ 0.05Ω | C6 = 360 pF
    [buckboost.kicad_sch]
2026-06-25 feat: CM4 migration
    Massive changes moving to use a CM4 for rubyfpv support. Power system sorted for ESP and PI, but not hawkeye v5s
    [CM4.kicad_sch, CM4_GPIO.kicad_sch, CM4_HighSpeed.kicad_sch, CM4_USB.kicad_sch, CM5.kicad_sch, CM5IO.kicad_pcb, CM5IO.kicad_sch, CM5_GPIO.kicad_sch]
