icl-rocketry/Ricardo-CameraController/(notices)

Notices in the files:
Camera-controller/CM4_HighSpeed.kicad_sch:
© 2020-2022 Raspberry Pi Ltd (formerly Raspberry Pi (Trading) Ltd.)
